mcqn/my-bikes-got-led/electronics/BoostCircuitTesting/boostcircuit/boostcircuit_board.svg.kicad_pcb

## KiCad design electronics/BoostCircuitTesting/boostcircuit/boostcircuit_board.svg.kicad_pcb (2022-10-07)

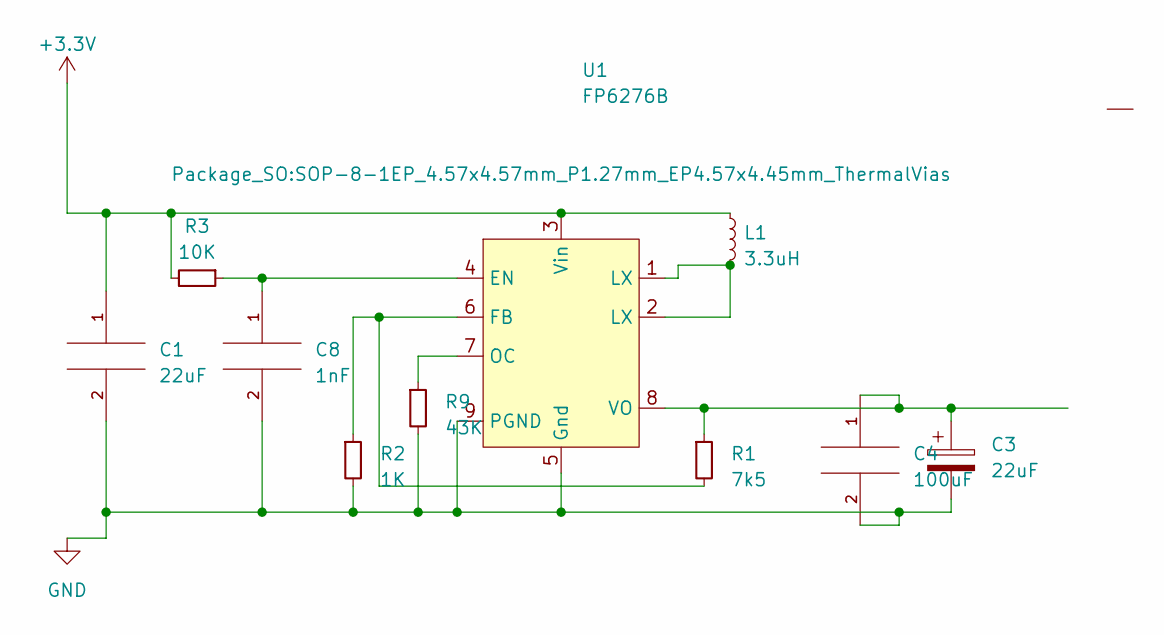
[picture p6: schematic boostcircuit_board.svg.kicad_sch]

Parts:
C1, C3: 22uF; C_0603_1608Metric_Pad1.08x0.95mm_HandSolder
C4: 100uF; C_0603_1608Metric_Pad1.08x0.95mm_HandSolder
C8: 1nF; C_0603_1608Metric_Pad1.08x0.95mm_HandSolder
L1: 3.3uH; L_Vishay_IHLP-2525
R1: 7k5; R_0603_1608Metric_Pad0.98x0.95mm_HandSolder
R2: 1K; R_0603_1608Metric_Pad0.98x0.95mm_HandSolder
R3: 10K; R_0603_1608Metric_Pad0.98x0.95mm_HandSolder
R9: 43K; R_0603_1608Metric_Pad0.98x0.95mm_HandSolder
U1: FP6276B; SOP-8-1EP_4.57x4.57mm_P1.27mm_EP4.57x4.45mm_ThermalVias

Connections:
+3.3V: C1.1, L1.1, R3.2, U1.3 (Vin)
GND: C1.2, C3.2, C4.2, C8.2, R2.2, R9.2, U1.5 (Gnd), U1.9 (PGND)
unnamed: C8.1, R3.1, U1.4 (EN)
unnamed: R1.2, R2.1, U1.6 (FB)
unnamed: L1.2, U1.1 (LX), U1.2 (LX)
unnamed: R9.1, U1.7 (OC)
unnamed: C3.1, C4.1, R1.1, U1.8 (VO)

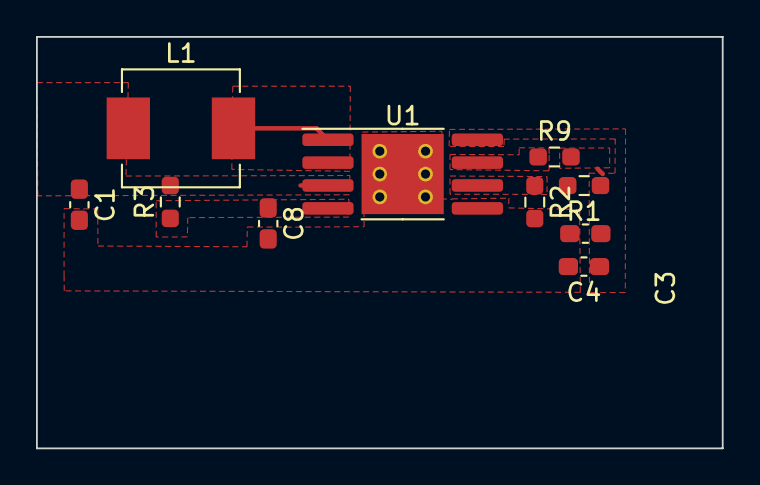
[picture p7: board boostcircuit_board.svg.kicad_pcb from above]

Board: 2 copper layers, 38.1 x 22.9 mm, 10 parts (0 on the bottom side), 7 nets.
